Boutot96/balance-bot/hardware/balance-bot/balance-bot_v2.kicad_pcb

## KiCad design hardware/balance-bot/balance-bot_v2.kicad_pcb (2026-10-20)

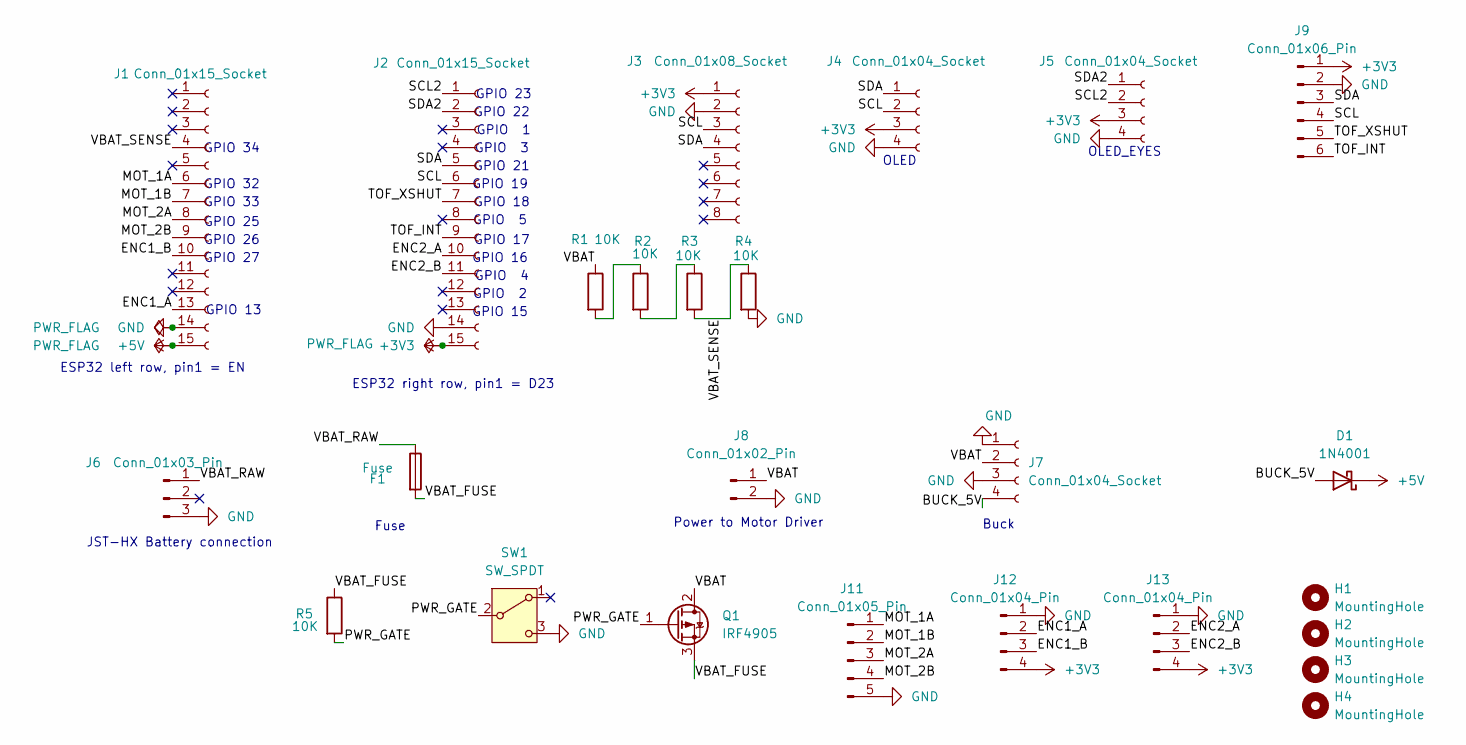
[picture p1: schematic balance-bot_v2.kicad_sch]

Parts:
D1: 1N4001; D_DO-41_SOD81_P10.16mm_Horizontal
F1: Fuse; Fuseholder_Cylinder-5x20mm_Schurter_0031_8201_Horizontal_Op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
H1, H2, H3, H4: MountingHole; MountingHole_3.2mm_M3
J1, J2: Conn_01x15_Socket; PinSocket_1x15_P2.54mm_Vertical
J3: Conn_01x08_Socket; PinSocket_1x08_P2.54mm_Vertical
J4, J5: Conn_01x04_Socket; PinSocket_1x04_P2.54mm_Vertical
J6: Conn_01x03_Pin; JST_XH_B3B-XH-A_1x03_P2.50mm_Vertical
J7: Conn_01x04_Socket; Buck_LM2596
J8: Conn_01x02_Pin; JST_XH_B2B-XH-A_1x02_P2.50mm_Vertical
J9: Conn_01x06_Pin; JST_XH_B6B-XH-A_1x06_P2.50mm_Vertical
J11: Conn_01x05_Pin; JST_XH_B5B-XH-A_1x05_P2.50mm_Vertical
J12, J13: Conn_01x04_Pin; JST_XH_B4B-XH-A_1x04_P2.50mm_Vertical
Q1: IRF4905; TO-220-3_Vertical
R1, R2, R3, R4, R5: 10K; R_Axial_DIN0207_L6.3mm_D2.5mm_P10.16mm_Horizontal
SW1: SW_SPDT; PinHeader_1x03_P2.54mm_Vertical

Connections:
+3V3: J2.15, J3.1, J4.3, J5.3, J9.1, J12.4, J13.4
+5V: D1.1 (K), J1.15
/BUCK_5V: D1.2 (A), J7.4
/ENC1_A: J1.13, J12.2
/ENC1_B: J1.10, J12.3
/ENC2_A: J2.10, J13.2
/ENC2_B: J2.11, J13.3
/MOT_1A: J1.6, J11.1
/MOT_1B: J1.7, J11.2
/MOT_2A: J1.8, J11.3
/MOT_2B: J1.9, J11.4
/PWR_GATE: Q1.1 (G), R5.2, SW1.2 (B)
/SCL: J2.6, J3.3, J4.2, J9.4
/SCL2: J2.1, J5.2
/SDA: J2.5, J3.4, J4.1, J9.3
/SDA2: J2.2, J5.1
/TOF_INT: J2.9, J9.6
/TOF_XSHUT: J2.7, J9.5
/VBAT: J7.2, J8.1, Q1.2 (D), R1.1
/VBAT_FUSE: F1.2, Q1.3 (S), R5.1
/VBAT_RAW: F1.1, J6.1
/VBAT_SENSE: J1.4, R3.2, R4.1
GND: J1.14, J2.14, J3.2, J4.4, J5.4, J6.3, J7.1, J7.3, J8.2, J9.2, J11.5, J12.1, J13.1, R4.2, SW1.3 (C)
unnamed: R1.2, R2.1
unnamed: R2.2, R3.1

Notes on the sheet:
GPIO 17
GPIO 15
GPIO 5
GPIO 2
GPIO 3
GPIO 26
GPIO 27
GPIO 34
Buck
Power to Motor Driver
GPIO 18
JST-HX Battery connection
ESP32 right row, pin1 = D23
OLED_EYES
GPIO 1
GPIO 16
GPIO 13
GPIO 32
GPIO 22
GPIO 4
GPIO 19
Fuse
GPIO 21
GPIO 33
GPIO 25
ESP32 left row, pin1 = EN
GPIO 23
OLED

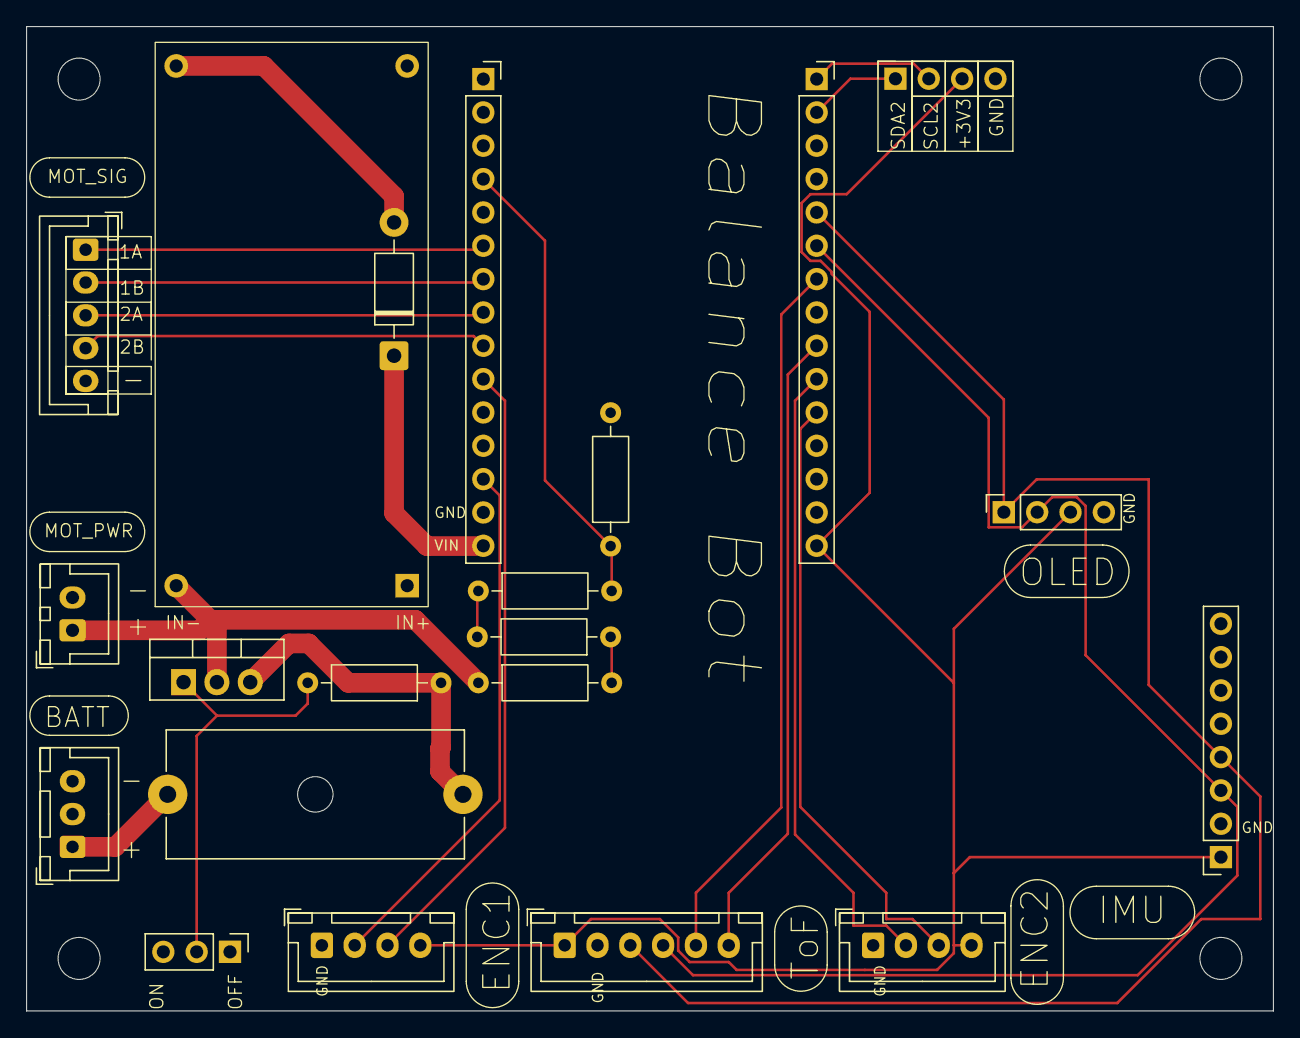
[picture p2: board balance-bot_v2.kicad_pcb from above]

Board: 2 copper layers, 95.0 x 75.0 mm, 25 parts (0 on the bottom side), 25 nets.
