Boutot96/balance-bot/src/main.cpp

#include "net.h"
#include "display.h"
#include "battery.h"
#include "imu.h"
#include "motor.h"
#include "config.h"
#include "balance.h"
#include "encoder.h"
#include "timing.h"
#include "teleop.h"
#include <Arduino.h>
#include <Wire.h>

static DisplayData currentData;

static WorkStats loopStats("loop"),  netStats("net"),   battStats("batt"),
                 encStats("enc"),    imuStats("imu+bal"), periodStats("period"),
                 eyesStats("eyes"),  statusStats("status"), reportStats("report");
static Every reportTimer(2000);
static Every dbgTimer(100);

static TaskHandle_t controlHandle = nullptr;
static hw_timer_t* controlTimer = nullptr;

static uint32_t overruns = 0;

static void IRAM_ATTR onControlTimer() {
    BaseType_t woke = pdFALSE;
    vTaskNotifyGiveFromISR(controlHandle, &woke);   // "wake up, it's time"
    if (woke) portYIELD_FROM_ISR();                 // switch to it right away
}

static void onOtaStart() {
    if (controlHandle) vTaskSuspend(controlHandle);   // control task stops running
    motorStop();                                      // now nothing can restart them
}

static void controlTask(void* param){
  //TickType_t lastWake = xTaskGetTickCount();
  //const TickType_t PERIOD = pdMS_TO_TICKS(IMU_PERIOD_MS);
  uint8_t encDiv = 0;
  uint32_t lastRun = micros();

  for(;;){
    //vTaskDelayUntil(&lastWake, PERIOD);     // sleep until next 5ms mark
    uint32_t pending = ulTaskNotifyTake(pdTRUE, portMAX_DELAY);
    if(pending > 1) overruns += pending - 1;

    uint32_t now = micros();
    periodStats.add(now - lastRun);
    lastRun = now;

    imuStats.start();
    if(++encDiv >= ENC_PERIOD_MS / IMU_PERIOD_MS) {
      encDiv = 0;
      encUpdate();
    }

    imuUpdate();
    float wheelSpeed = (encSpeed(ENC_LEFT) + encSpeed(ENC_RIGHT)) / 2.0f;
    balanceStep(imuAngle(), imuRate(), imuDt(), wheelSpeed);
    imuStats.stop();

  }


}

static void housekeepingTask(void*) {
    for (;;) {
        netService();
        battService();
        vTaskDelay(pdMS_TO_TICKS(10));    // "about every 10 ms" — doesn't need to be exact
    }
}

void setup() {
  motorSetup();
  Serial.begin(115200);
  delay(1000);

  Wire.begin(SDA_PIN, SCL_PIN);
  Wire1.begin(SDA2_PIN, SCL2_PIN);

  if (!imuSetup()) {
    snprintf(currentData.imu_status, sizeof(currentData.imu_status), "Failed");
  }
  else {
    snprintf(currentData.imu_status, sizeof(currentData.imu_status), "Successful");
  }

  battSetup();

  displaySetup();
  netSetup();
  netOnUploadStart(onOtaStart);
  snprintf(currentData.ip, sizeof(currentData.ip), "%s", netIP());
  encSetup();

  xTaskCreatePinnedToCore(
    controlTask,      // function
    "control",        // name
    4096,             // stack, bytes
    nullptr,          // param
    5,                // priority (loop() is 1)
    &controlHandle,   // handle
    1                 // core
  );

  xTaskCreatePinnedToCore(housekeepingTask, "house", 4096, nullptr, 1, nullptr, 0);

  controlTimer = timerBegin(0, 80, true);            // timer 0, 80 MHz / 80 = 1 MHz → 1 tick = 1 µs, count up
  timerAttachInterrupt(controlTimer, &onControlTimer, true);
  timerAlarmWrite(controlTimer, IMU_PERIOD_MS * 1000, true);   // 5000 µs, auto-reload
  timerAlarmEnable(controlTimer);

}

void loop() {
    loopStats.start();

    eyesStats.start();
    eyeService(imuAngle());
    eyesStats.stop();

    currentData.batteryPct = battPercentage();
    currentData.angle      = imuAngle();
    if (!balanceArmed()) {
        statusStats.start();
        displayUpdate(currentData);
        statusStats.stop();
    }

    loopStats.stop();

    // ---- bring-up checks: signs, encoders, battery (10 Hz) ----
    if (LOG_BRINGUP && dbgTimer.ready()) {
        netLog("arm %d ang %6.2f rate %7.1f  L %5.2f R %5.2f  bat %.2fV\n",
               balanceArmed(), imuAngle(), imuRate(),
               encSpeed(ENC_LEFT), encSpeed(ENC_RIGHT), battVoltage());
    }

    // ---- timing report (every 2 s) ----
    if (LOG_TIMING && reportTimer.ready()) {
        reportStats.start();
        netLog("---- overruns %lu\n", (unsigned long)overruns);
        loopStats.report();  periodStats.report(); imuStats.report();
        eyesStats.report();  statusStats.report(); displayReport();
        reportStats.report();
        reportStats.stop();
    }
}
