Boutot96/balance-bot/include/net.h

#pragma once

// Sets up Wifi, OTA, and Telnet. Call once in setup()
void netSetup();

// Returns true if Wifi is connected, false otherwise
bool netConnected();

// Writes a message to the Telnet console and Serial monitor
void netLog(const char *fmt, ...);

// Answers OTA upload requests. Is ran every loop iteration
void netService();

//Returns ip address as a string. 0.0.0.0 if not connected
const char* netIP();

// Register a function to run when an OTA upload starts (e.g. stop motors).
void netOnUploadStart(void (*callback)());
