Boutot96/balance-bot/include/secrets.example.h

// Fill in with your WiFi credentials and OTA password. Rename this file to secrets.h and 
// Make sure secrets.h is in .gitignore and do not commit it to git.
#pragma once
constexpr const char* WIFI_SSID = "your-wifi";
constexpr const char* WIFI_PASS = "your-password";
constexpr const char* OTA_PASS  = "your-ota-password";
