Boutot96/balance-bot/(commit log)

2026-10-12 Display module added and displays ip adress. Skeleton for battery module made for monitoring battery levels
2026-10-12 Battery module added for battery monitoring. Battery life sent to display
2026-10-13 Added IMU module with gyro calibration and complemtary filter
    Bubble level on display, driven by IMU pitch angle.
2026-10-13 Added motor control, start and stop functions along with setup.
2026-10-13 Added carrier board schematic (ERC clean)
    [balance-bot.kicad_pcb, balance-bot.kicad_sch]
2026-10-13 Schematic: MOSFET soft power switch, fuse, buck/diode, connectors (ERC clean)
    [balance-bot.kicad_sch]
2026-10-13 Schematic complete, footprints assigned
    [balance-bot.kicad_sch]
2026-10-14 PCB v1.0: complete layout and routing
    [balance-bot.kicad_pcb, balance-bot.kicad_sch]
2026-10-16 PCB v1.0 Created 3d models and gerber files. Moved balancing step into its own module and set up pins for the encoders
    [balance-bot-B_Cu.gbl, balance-bot-B_Mask.gbs, balance-bot-B_Silkscreen.gbo, balance-bot-Edge_Cuts.gm1, balance-bot-F_Cu.gtl, balance-bot-F_Mask.gts, balance-bot-F_Silkscreen.gto, balance-bot-NPTH.drl]
2026-10-16 Add encoder module: qudrature-ish counting, measured dt speed
2026-10-16 Encoder module + cascaded speed loop: balances in place
2026-10-17 Split IMU/encoder into service (timing) + update (work)
2026-10-17 Control loop moved to FreeRTOS task (prio 5, core 1): period jitter ±3ms → ±0.65ms
    [imu.h, main.cpp]
2026-10-17 Hardware-timer-driven control task: period jitter ±10µs, no tick slips
    [display.cpp, main.cpp]
2026-10-20 V2 PCB bring-up: setpoint +2.0, ENC2_DIR flipped, Wire1 eyes, balancing
    [config.h, display.cpp, main.cpp]
2026-10-20 Teleop commands sent over nc working but needs refinment. V2 for pcb board, fixes buck converter flip and spacing for switch along with some trace optimization.
    [balance-bot_v2.kicad_pcb, balance-bot_v2.kicad_sch]
